lgog2/cycloneIV-watchdog-cgp/doc/external_schematic.pdf

## COMPUTER

PC

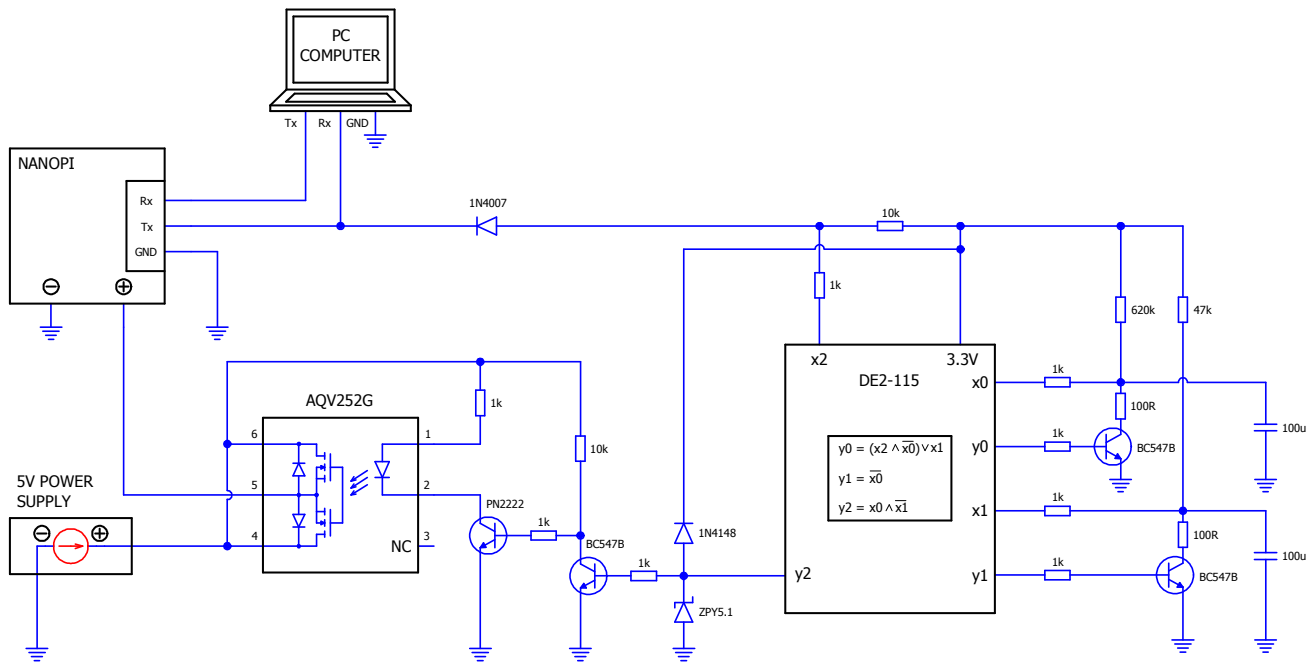
[picture p1: page 1]
GND; NANOPI; AQV252G; 5V POWER SUPPLY; ZPY5.1
