lgog2/cycloneIV-watchdog-cgp/LUT4Cell.vhd

----------------------------------------------------------------------------------
-- file name: LUT4Cell.vhd
-- DESCRIPTION:
--		Configurable 4-input Look-Up Table (LUT4)
--		Integrates programmable truth table with routing multiplexers
--		to dynamically select signals from the global signal bus.
--		Building block for the CGP DAG Reconfigurable Circuit (VRC).
--		NOTE:
--		Deliberately not parameterized - width of truth table and number of inputs
--		hardcoded to match current single-cycle model of fault injection from NIOS:
--		-both Permanent Bit Inversion(PBI) and Stuck-At in one 32-bit word.
----------------------------------------------------------------------------------

library ieee;
use ieee.std_logic_1164.all;
use IEEE.NUMERIC_STD.ALL;

use work.consts_pkg.all;

entity Lut4Cell is
	port(
		-- global input bus (30 LUT outputs + 3 external inputs = 33 signals)
		all_signals_in		: in  std_logic_vector(TOTAL_SIGNALS_WIDTH - 1 downto 0); --0-32

		-- input routing configuration
		--(selects which signals from all_signals_in connect to the 4 LUT inputs):
		-- only indices 0-31 are addressable (5bit)
		-- index 32 (output of the 30th LUT) is unreachable (DAG topology)
		-- Bits [19:15] : i3 selector
		-- Bits [14:10] : i2 selector
		-- Bits [9:5]   : i1 selector
		-- Bits [4-0]   : i0 selector
		conf_routing_in		: in  std_logic_vector(19 downto 0);

		conf_F_in 			: in std_logic_vector(15 downto 0);

		-- FAULT INJECTION BUS:
		-- Bits [31:16] : Permanent Bit Inversion mask (Hard Errors applied via XOR to the Truth Table)
		-- Bits [15:13] : unused
		-- Bits [12:8]  : SA_VAL mask (Stuck-At Value: 1=VCC, 0=GND for [OUT, I3, I2, I1, I0])
		-- Bits [7:5]   : unused
		-- Bits [4:0]   : SA_EN mask  (Stuck-At Enable: 1=Fault Active, 0=Healthy for [OUT, I3, I2, I1, I0])
		fault_mask_in		: in  std_logic_vector(31 downto 0);

		out_signal			: out std_logic

	);
end Lut4Cell;

architecture rtl of Lut4Cell is

	signal sel_i0, sel_i1, sel_i2, sel_i3	: integer range 0 to 31; --
	signal i0, i1, i2, i3 : std_logic;
	signal address : integer range 0 to 15;

	signal i0_f, i1_f, i2_f, i3_f			: std_logic;
	signal raw_out							: std_logic;
	signal corrupted_F						: std_logic_vector(15 downto 0);
begin
	-- decoding 5-bit routing configuration into integer selectors
	sel_i0		<= to_integer(unsigned(conf_routing_in(4 downto 0)));
	sel_i1		<= to_integer(unsigned(conf_routing_in(9 downto 5)));
	sel_i2		<= to_integer(unsigned(conf_routing_in(14 downto 10)));
	sel_i3		<= to_integer(unsigned(conf_routing_in(19 downto 15)));

	i0			<= all_signals_in(sel_i0);
	i1			<= all_signals_in(sel_i1);
	i2			<= all_signals_in(sel_i2);
	i3			<= all_signals_in(sel_i3);

	-- applying STUCK-AT to inputs: (AND NOT Enable) OR (Value AND Enable)
	i0_f		<= (i0 and not fault_mask_in(0)) or (fault_mask_in(8)  and fault_mask_in(0));
	i1_f		<= (i1 and not fault_mask_in(1)) or (fault_mask_in(9)  and fault_mask_in(1));
	i2_f		<= (i2 and not fault_mask_in(2)) or (fault_mask_in(10) and fault_mask_in(2));
	i3_f		<= (i3 and not fault_mask_in(3)) or (fault_mask_in(11) and fault_mask_in(3));

	address		<= to_integer(unsigned'(i3_f & i2_f & i1_f & i0_f));

	--SPBI/MPBI
	corrupted_F	<= conf_F_in xor fault_mask_in(31 downto 16);

	raw_out		<= corrupted_F(address);

	-- applying STUCK-AT to output (SA_EN bit 4, SA_VAL bit 12) [(AND NOT Enable) OR (Value AND Enable)]
	out_signal	<= (raw_out and not fault_mask_in(4)) or (fault_mask_in(12) and fault_mask_in(4));

end rtl;
