lgog2/cycloneIV-watchdog-cgp/core.vhd

----------------------------------------------------------------------------------
-- file name: core.vhd
-- DESCRIPTION:
--		30-LUT Virtual Reconfigurable Circuit (VRC) asynchronous core.
--		Implements dynamic reconfiguration of LUT truth tables and
--		routing via Avalon-MM.
--		Hardware constraints enforce Directed Acyclic Graph (DAG) topology
--		to prevent combinational loops.
----------------------------------------------------------------------------------

library IEEE;
use IEEE.STD_LOGIC_1164.ALL;
use IEEE.NUMERIC_STD.ALL;

use work.consts_pkg.all;



entity core is
	-- external interface:
	-- 		x_in(0) : 60s capacitor state
	-- 		x_in(1) : 5s capacitor state
	-- 		x_in(2) : heartbeat signal from NanoPi
	-- 		y_out(0): 60s capacitor discharge signal
	--		y_out(1): 5s capacitor discharge signal
	--		y_out(2): NanoPi power cutoff signal
	Port (
		x_in			: in  std_logic_vector(NUM_EXT_INPUTS - 1 downto 0);--3
		y_out			: out std_logic_vector(NUM_EXT_OUTPUTS - 1 downto 0); --3

		-- configuration from NIOS -61cycles (61x32bits)
		-- genotype format [30 x [F, in0, in1, in2, in3], out0, out1, out2]
		conf_routing_in	: in  conf_routing_arr_t;
		conf_F_in		: in  conf_F_arr_t;
		conf_out_in		: in  conf_out_arr_t;

		-- faults injection
		fault_masks_in	: in conf_fault_arr_t

	);
end core;

architecture rtl of core is

	signal lut_outputs     : std_logic_vector(NUM_LUTS - 1 downto 0);

	--- global input bus (3 external + 30 LUT outputs = 33)
	signal all_signals		: std_logic_vector(TOTAL_SIGNALS_WIDTH - 1 downto 0); --0-32

	-- input matrix for each LUT
	type node_inputs_matrix_t is array (0 to NUM_LUTS - 1) of std_logic_vector(TOTAL_SIGNALS_WIDTH - 1 downto 0);
	signal node_inputs_matrix : node_inputs_matrix_t;


begin
	-- x_in at the lowest indices of global input bus
	all_signals <= lut_outputs & x_in;

	-- ==============================================================================
	-- PERFECT SEED TRUTH TABLE DOCUMENTATION
	-- ==============================================================================
	-- lut_0  y0 = (I2 & ~I0) | I1
	-- lut_1  y1 = ~I0
	-- lut_2  y2 = I0 & ~I1
	-- ------------------------------------------------------------------------------
	-- ADDR  | I3 I2 I1 I0 || lut_0 | lut_1 | lut_2 |
	-- (Dec) |  8  4  2  1 || y0_out| y1_out| y2_out|
	-- ------------------------------------------------------------------------------
	--   0   |  0  0  0  0 ||   0   |   1   |   0   |
	--   1   |  0  0  0  1 ||   0   |   0   |   1   |
	--   2   |  0  0  1  0 ||   1   |   1   |   0   |
	--   3   |  0  0  1  1 ||   1   |   0   |   0   |
	--   4   |  0  1  0  0 ||   1   |   1   |   0   |
	--   5   |  0  1  0  1 ||   0   |   0   |   1   |
	--   6   |  0  1  1  0 ||   1   |   1   |   0   |
	--   7   |  0  1  1  1 ||   1   |   0   |   0   |
	-- ------------------------------------------------------------------------------
	--   8   |  1  0  0  0 ||   0   |   1   |   0   |
	--   9   |  1  0  0  1 ||   0   |   0   |   1   |
	--  10   |  1  0  1  0 ||   1   |   1   |   0   |
	--  11   |  1  0  1  1 ||   1   |   0   |   0   |
	--  12   |  1  1  0  0 ||   1   |   1   |   0   |
	--  13   |  1  1  0  1 ||   0   |   0   |   1   |
	--  14   |  1  1  1  0 ||   1   |   1   |   0   |
	--  15   |  1  1  1  1 ||   1   |   0   |   0   |
	-- ------------------------------------------------------------------------------
	-- lut_0.F = 16'hDCDC  (Bin: 16'b1101_1100_1101_1100)  Dec: 16'd56540)
	-- lut_1.F = 16'h5555  (Bin: 16'b0101_0101_0101_0101)  Dec: 16'd21845)
	-- lut_2.F = 16'h2222  (Bin: 16'b0010_0010_0010_0010)  Dec: 16'd8738)
	-- ==============================================================================

-----------------------------------------------------------------------------------------
	-- DAG enforcement for Quartus Analysis & Synthesis (without constraint,
	-- the synthesizer detects combinational loops and fails timing analysis)
	gen_matrix_rows: for i in 0 to NUM_LUTS - 1 generate

		-- no connections from higher-indexed LUTs and self
		node_inputs_matrix(i)(TOTAL_SIGNALS_WIDTH - 1 downto i + NUM_EXT_INPUTS) <= (others => '0');

		-- connections from lower-indexed LUTs and external inputs allowed only
		node_inputs_matrix(i)(i + NUM_EXT_INPUTS - 1 downto 0) <= all_signals(i + NUM_EXT_INPUTS - 1 downto 0);

	end generate;
-----------------------------------------------------------------------------------------

	-- generating the 30-LUT core matrix
	gen_cgp_nodes: for i in 0 to NUM_LUTS - 1 generate
	begin
		lut_cell_inst : entity work.Lut4Cell
		port map (
			--inputs:
			all_signals_in	=> node_inputs_matrix(i),
			conf_routing_in	=> conf_routing_in(i),
			conf_F_in		=> conf_F_in(i),
			fault_mask_in	=> fault_masks_in(i),

			--output:
			out_signal		=> lut_outputs(i)
		);
	end generate;

	-- output routing multiplexers with safe boundary checking (for Quartus syntesis)
	y_out(0) <= all_signals(to_integer(unsigned(conf_out_in(0)))) when to_integer(unsigned(conf_out_in(0))) < TOTAL_SIGNALS_WIDTH else '0';
	y_out(1) <= all_signals(to_integer(unsigned(conf_out_in(1)))) when to_integer(unsigned(conf_out_in(1))) < TOTAL_SIGNALS_WIDTH else '0';
	y_out(2) <= all_signals(to_integer(unsigned(conf_out_in(2))) )when to_integer(unsigned(conf_out_in(2))) < TOTAL_SIGNALS_WIDTH else '0';

end rtl;
