lgog2/cycloneIV-watchdog-cgp/(commit log)

2026-07-18 Initial commit: Hardware baseline for CGP watchdog
    - Add wrapper FSM with 50 MHz to 3 Hz ZOH synchronization.
    - Instantiate 30-node VRC core (baseline logic hardcoded in first 3 LUTs).
    - Map physical I/O for DE2-115 (RC circuit, power relay, diagnostic LEDs).
    - Add README.md with architectural documentation and roadmap.
2026-08-01 feat: implement dynamic DAG reconfiguration via Avalon-MM and Nios II
    - Integrated Nios II softcore with JTAG UART and on-chip memory via Qsys.
    - Replaced static 3-LUT logic with a dynamically reconfigurable 30-LUT Virtual Reconfigurable Circuit (VRC).
    - Designed memory-mapped control registers (Avalon-MM) to dynamically update LUT functions and the routing matrix.
    - Implemented a hardware constraint matrix (node_inputs_matrix) in VHDL to physically prevent combinational loops (back-edges) and enforce DAG topology during Quartus synthesis.
    - Added a 7-cycle multi-cycle path (140ns) constraint in SDC and corresponding wait states in the Watchdog FSM to ensure safe combinational evaluation acr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
    [LUT4Cell.vhd, UART_detector.vhd, consts_pkg.vhd, core.vhd, de2_115_top.vhd, main.c]
2026-08-04 fix: add 'eval_done' and 'fitness' fields to status_reg
    - Decoupled real-time FSM background operations from Avalon-MM software reads
    by introducing 'snapshot_eval_done' and 'snapshot_fitness' registers.
    - Adapted C test files to align with the new architecture.
    [main.c, wrapper.vhd]
2026-08-11 feat: implement software CGP engine and harden Nios II-VRC synchronization
    Software:
    - Developed CGP algorithm in C using (1+4) Evolution Strategy.
    - Implemented pseudo-fault injection to configuration registers of a healthy VRC matrix to validate evolutionary recovery.
    - Built a Reverse Topological Traversal algorithm to extract and visualize the active phenotype (DAG of LUTs).
    - Adapted existing C test programs to hardware changes.
    Hardware:
    - Cascaded hardware multipliers (3x 16-bit) and the mulxuu extended instruction enabled in Nios II ALU to execute Fast Range math without soft-math emulation.
    - Interval Timer IP added to precisely profile the CGP engine's evol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
    [cgp_engine.c, cgp_engine.h, main.c, wrapper.vhd]
2026-08-16 feat: implement hardware fault injection network and TMR-protected expected truth table
    - Add 32-bit memory-mapped shadow registers via Avalon-MM to inject physical Stuck-At (SA0/SA1) and SEU/MBU faults directly into the LUT matrix using XOR/AND/OR logic overlays.
    - Introduce dynamic, Nios-reconfigurable expected truth table for the hardware evaluator, protected by zero-cycle Triple Modular Redundancy (TMR).
    - Remove generic parameter (NODE_INDEX) from `LUT4Cell`.
    - Update README.md.
    [LUT4Cell.vhd, consts_pkg.vhd, core.vhd, wrapper.vhd]
2026-09-02 fix(hardware): enforce waitrequest on Avalon-MM writes
    - fix multiple executions of commands from NIOS during the waitrequest.
    - prevent potential data tearing by locking all configuration registers while waitrequest is set.
    [wrapper.vhd]
2026-09-20 feat: implement hardware (1+1)-ES evolution and Avalon-MM shadow registers
    - Hardware Evolution Engine: Implemented autonomous (1+1)-ES algorithm inside the FSM (ST_REPAIR). Replaced PRNG with 64-bit xorshift64.vhd and added mutation_engine.vhd scaled via DSP multipliers for combinatorial gene generation.
    - Shadow Registers & Readback: Added shadow configuration registers. Configurations are loaded to active VRC registers only upon explicit load_conf_cmd, preventing data tearing. Enabled reading the active hardware configuration back to Nios II via Avalon-MM.
    - Nios II Control Interface: Replaced command_reg with ctrl_reg. Hardware evolution defaults to ON but can be bypassed using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
    [LUT4Cell.vhd, cgp_engine.c, cgp_engine.h, consts_pkg.vhd, core.vhd, main.c, mutation_engine.vhd]
2026-09-26 refactor(hardware): parameterize clock timings, harden CDC synchronizers, refine SDC constraints and unify PoR/LED stretchers
2026-09-28 test: implement 6 additional fault injection tests, logical DAG analysis, and add test logs
    Software (main.c):
    - Add 6 cumulative fault injection tests: Active-DAG cumulative fault injection (Tests 2-3: IN SA0/1, PBI), and Continuous Full-Matrix asynchronous injection (Tests 4-7: PBI, IN, OUT, 16:4:1 Mix).
    - Add Boolean difference sensitivity analysis (is_input_logically_active) and extract_active_nodes() to identify logically active DAG nodes and inputs.
    - Add hardware PRNG seeding (CMD_LOAD_SEED), bit-mask truth-table mutation, and ISR timestamping for 5.0 s panic-timeout tracking.
    Docs:
    - Add UART logs for all fault injection tests in doc/test_logs/.
    - Update README.md
2026-10-01 fix: update component description and mutation_engine.vhd documentation headers
    [mutation_engine.vhd]
2026-10-02 docs: add system schematic SVG and external schematic PDF, update README link
